DragonflyValkyrie/Fan-Speed-Controller/(commit log)

2024-03-13 Electrical Schemetic Completed
    [Fan Speed Controller.kicad_pcb, Fan Speed Controller.kicad_sch]
2024-03-14 Completed V1 of circuit/board
    [Fan Speed Controller-CuBottom.gbr, Fan Speed Controller-CuTop.gbr, Fan Speed Controller-EdgeCuts.gbr, Fan Speed Controller-MaskBottom.gbr, Fan Speed Controller-MaskTop.gbr, Fan Speed Controller-NPTH.drl, Fan Speed Controller-PTH.drl, Fan Speed Controller-PasteBottom.gbr]
